ochaloup/sorting-hat/schema/schema_v5_graphviz.png

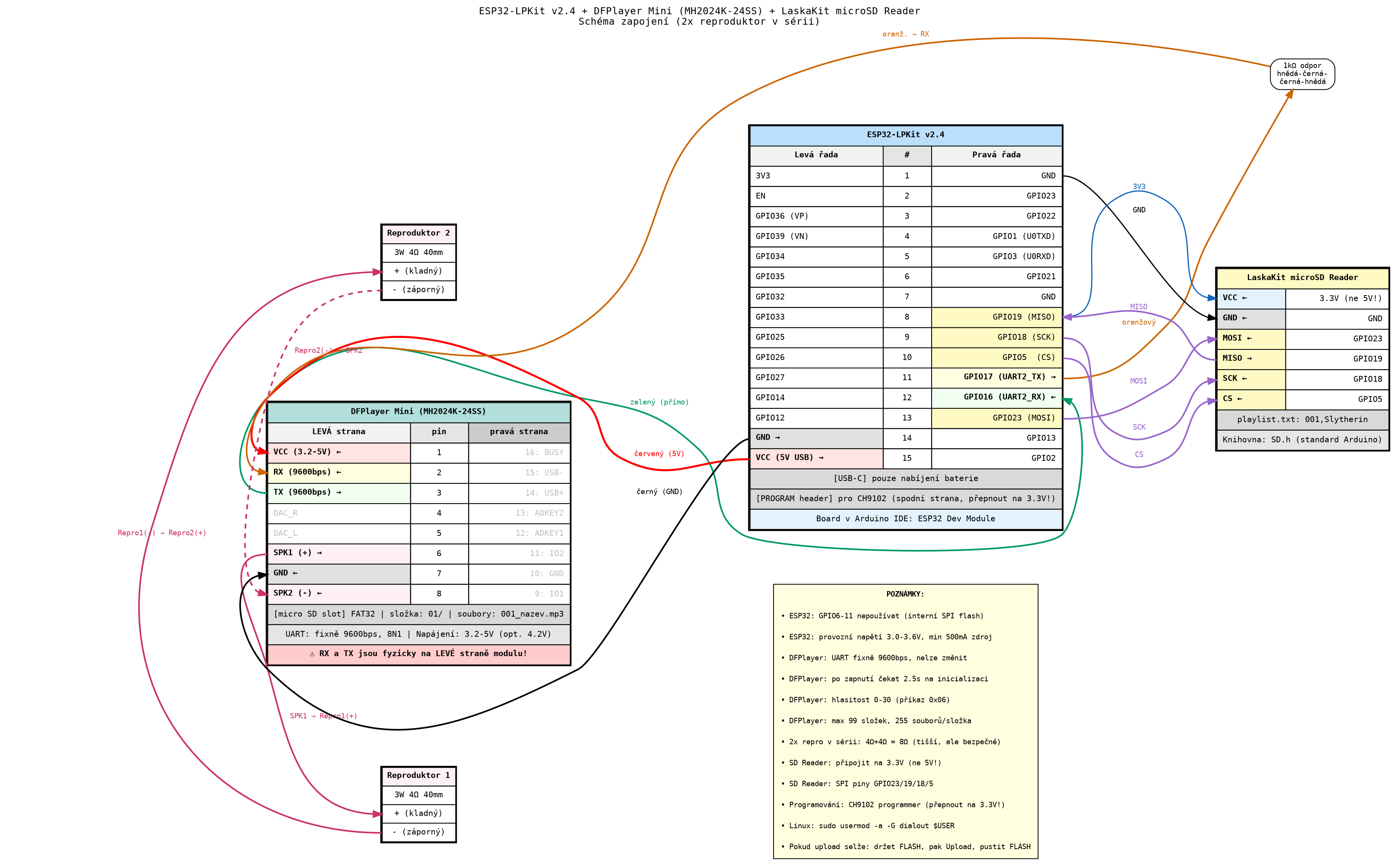
schema/schema_v5_graphviz.png
