ochaloup/sorting-hat/schema/zapojeni-schema-v3.png

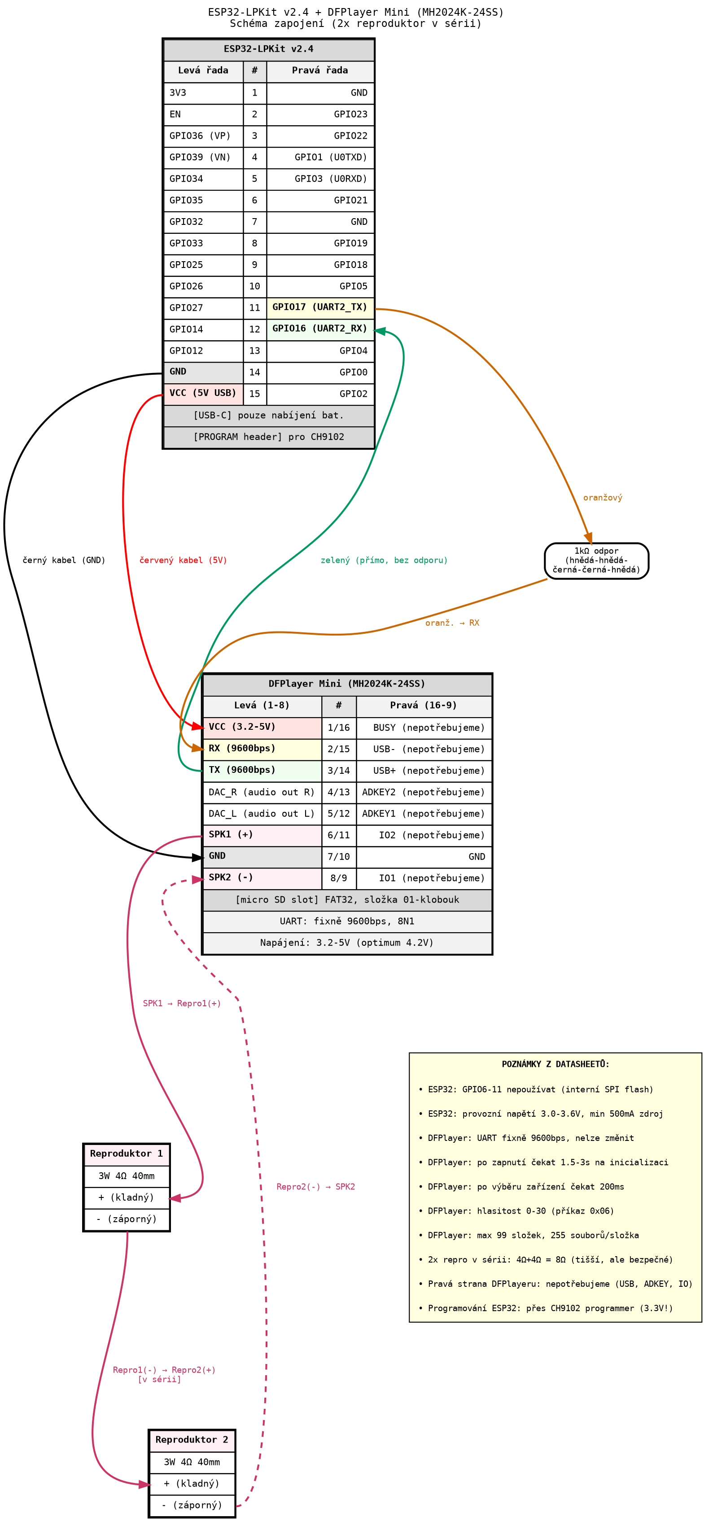
schema/zapojeni-schema-v3.png
