ochaloup/sorting-hat/tutorial/01 ide.png

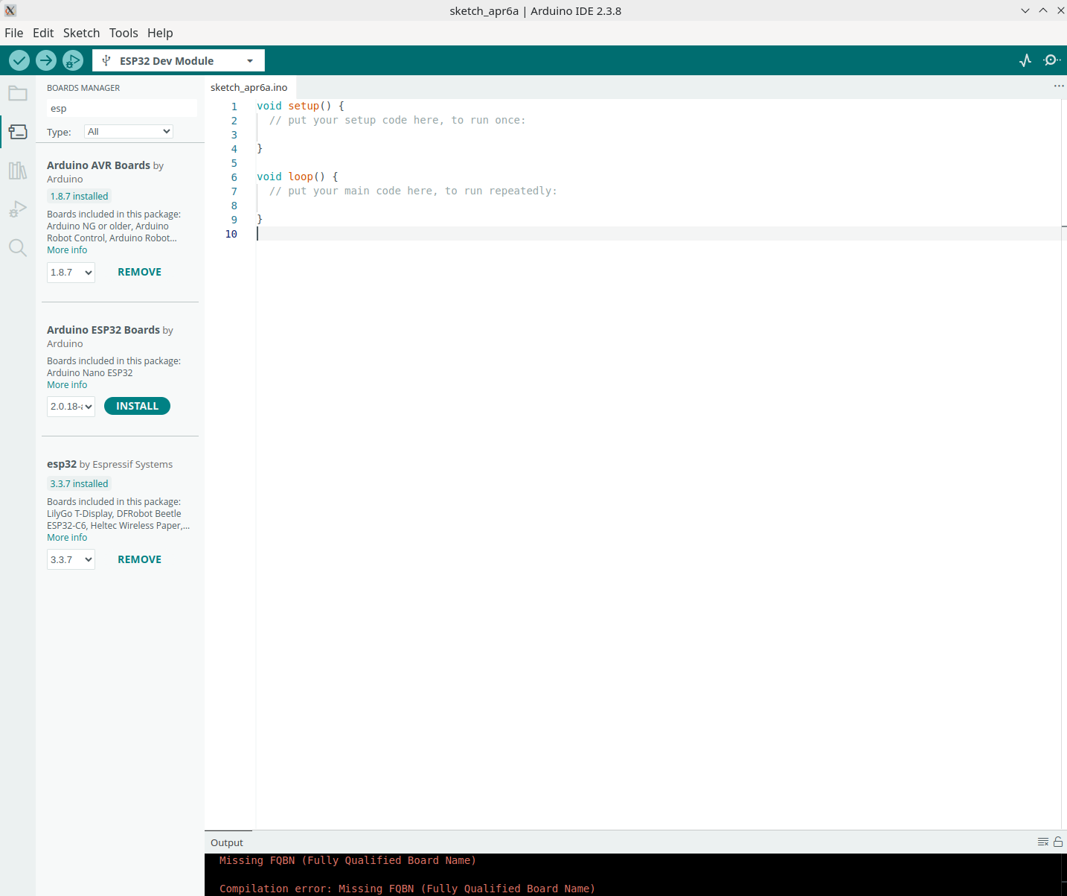
tutorial/01 ide.png
